protom-org/tk-48/README.md

# tk-48

- 8048を使ったトレーニングボード。シリアル通信でHEXファイルをボード上のRAM又はEEPROMにアップロードして実行が可能。
- KiCADで設計PCBWayで白レジスト基板を作成。

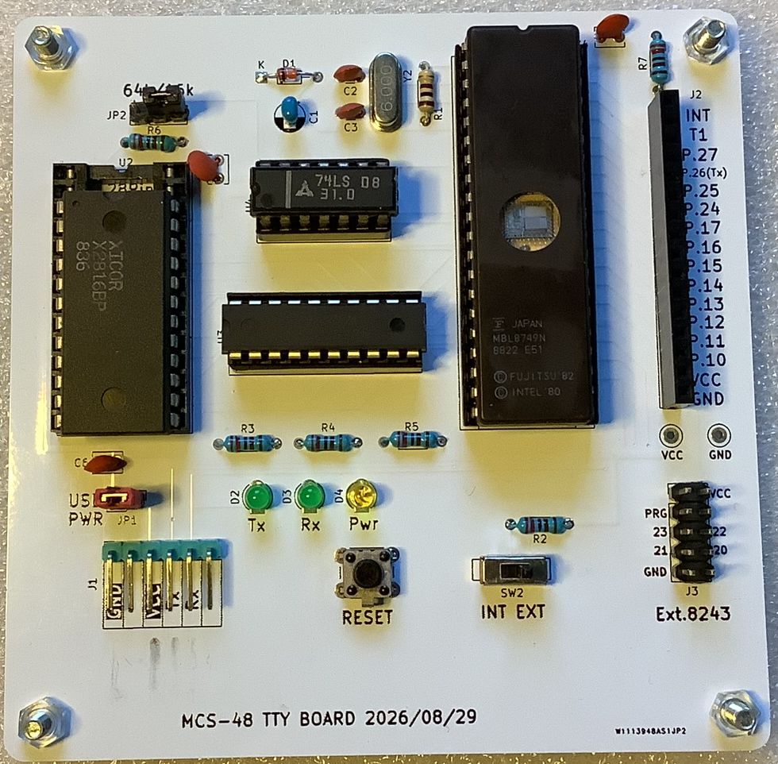
[picture p1: doc/assembly.jpg]
組立完成

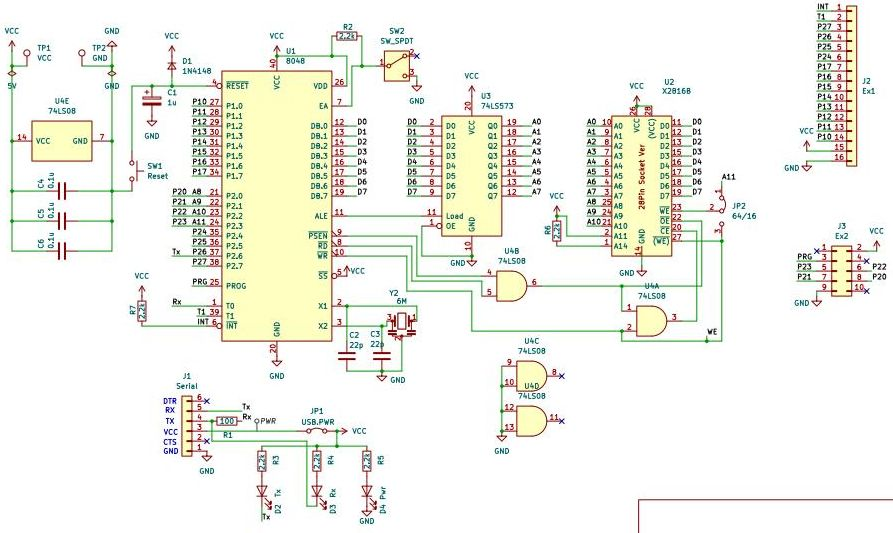
[picture p2: doc/tk48-schematic.jpg]
回路図

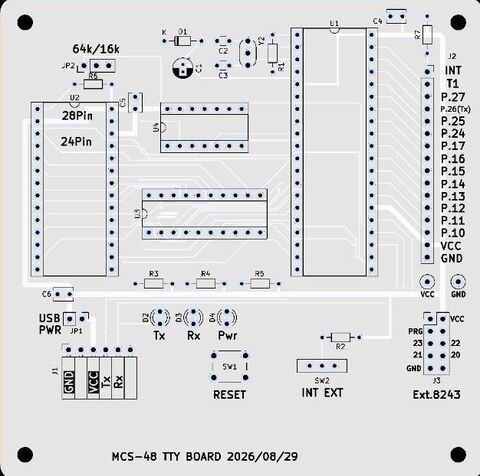
[picture p3: doc/board.jpg]
ボード


## [サポートサイトのWebページ](https://www.protom.org/micon/tk-48)
