protom-org/tk-48/doc/tk48-schematic.pdf

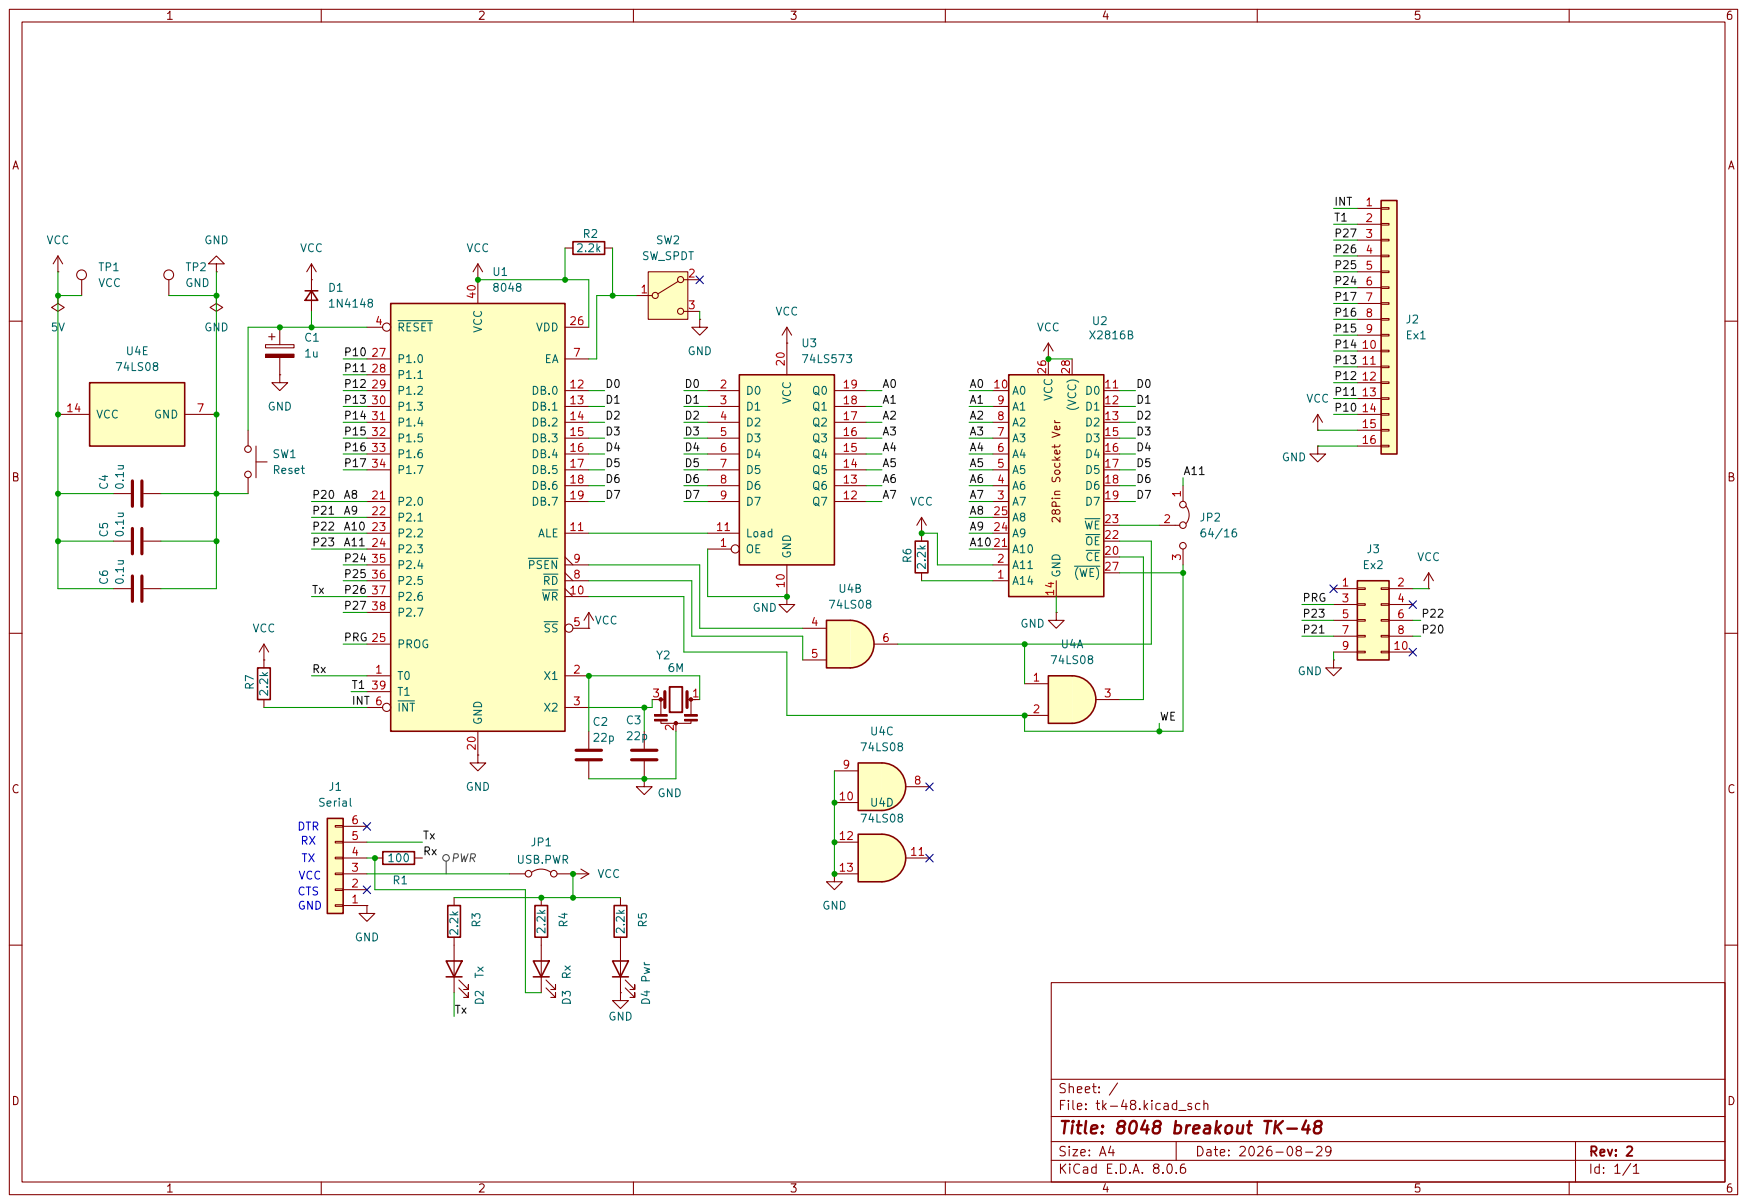
[picture p4: page 1]
