protom-org/tk-48/kicad/tk-48.kicad_pcb

## KiCad design kicad/tk-48.kicad_pcb (2026-11-13)

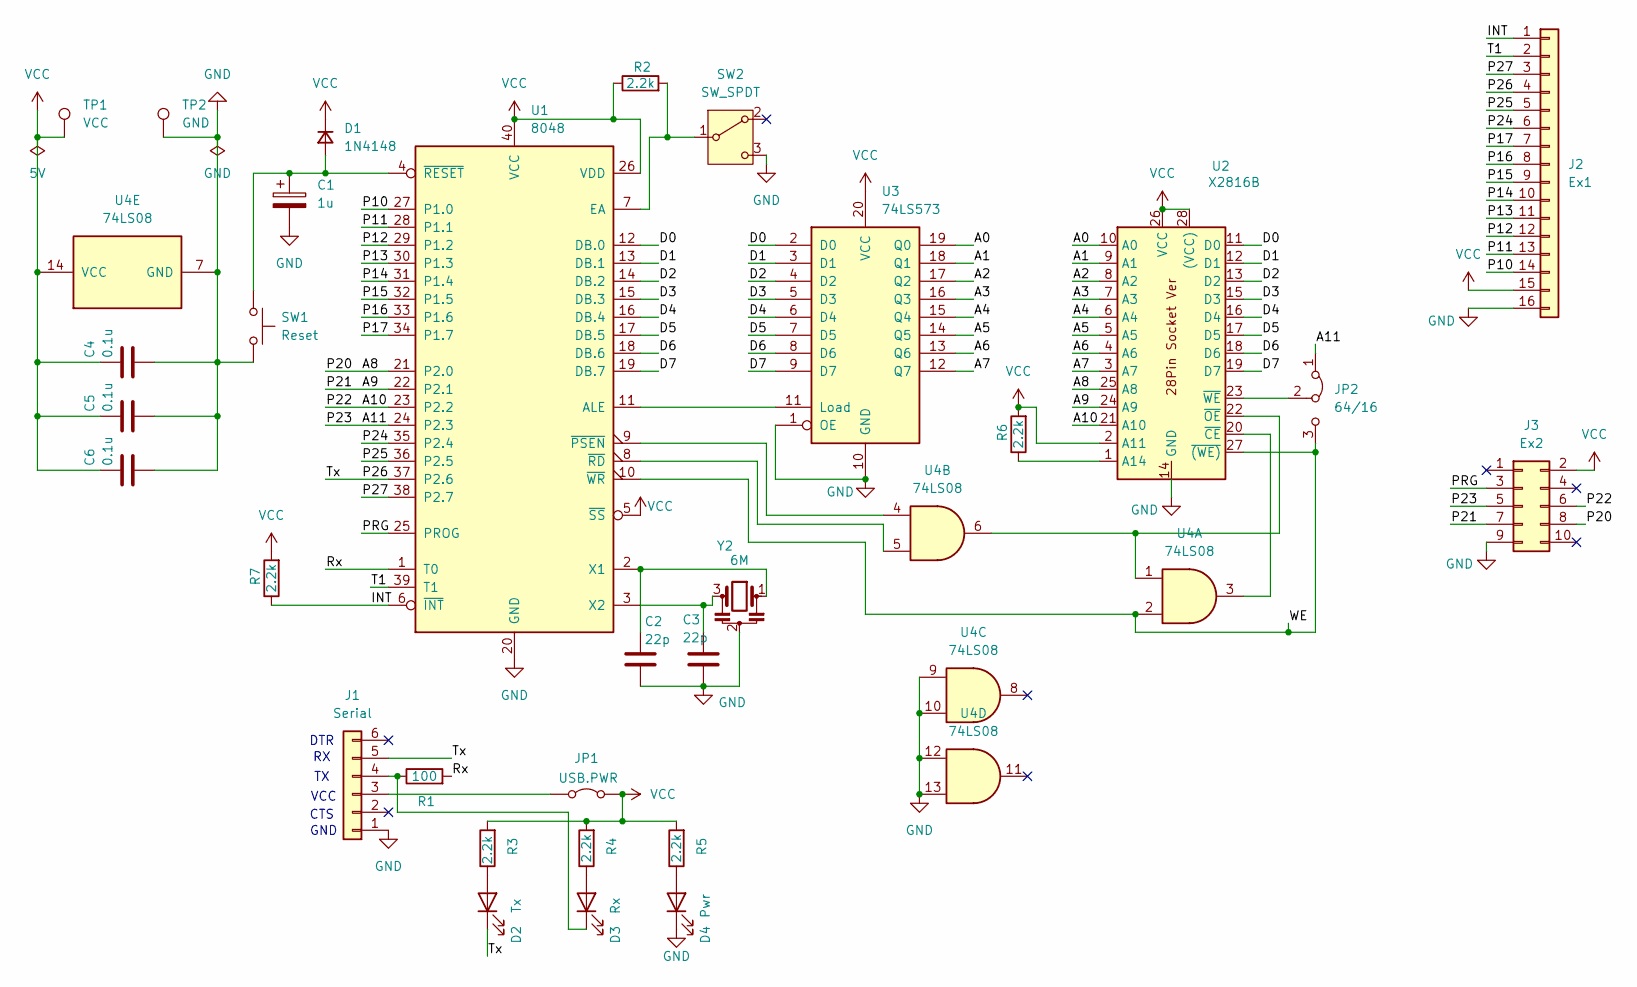
[picture p5: schematic tk-48.kicad_sch, 8048 breakout TK-48]

Parts:
C1: 1u; CP_Radial_D4.0mm_P1.50mm
C2, C3: 22p; C_Disc_D3.0mm_W1.6mm_P2.50mm
C4, C5, C6: 0.1u; C_Disc_D3.8mm_W2.6mm_P2.50mm
D1: 1N4148; D_DO-34_SOD68_P7.62mm_Horizontal
D2: Tx; LED_D3.0mm
D3: Rx; LED_D3.0mm
D4: Pwr; LED_D3.0mm
J1: Serial; PinHeader_1x06_P2.54mm_Horizontal
J2: Ex1; PinSocket_1x16_P2.54mm_Vertical
J3: Ex2; PinHeader_2x05_P2.54mm_Vertical
JP1: USB.PWR; PinHeader_1x02_P2.54mm_Vertical
JP2: 64/16; PinHeader_1x03_P2.54mm_Vertical
R1: 100; R_Axial_DIN0204_L3.6mm_D1.6mm_P7.62mm_Horizontal
R2, R3, R4, R5, R6, R7: 2.2k; R_Axial_DIN0204_L3.6mm_D1.6mm_P7.62mm_Horizontal
SW1: Reset; SW_PUSH_6mm_H8.5mm
SW2: SW_SPDT; SW_Slide-03_Wuerth-WS-SLTV_10x2.5x6.4_P2.54mm
TP1: VCC; TestPoint_Loop_D1.80mm_Drill1.0mm_Beaded
TP2: GND; TestPoint_Loop_D1.80mm_Drill1.0mm_Beaded
U1: 8048; DIP-40_W15.24mm_Socket
U2: X2816B; DIP-28_W15.24mm_Socket
U3: 74LS573; DIP-20_W7.62mm_Socket
U4: 74LS08; DIP-14_W7.62mm_Socket
Y2: 6M; Resonator_Murata_CSTLSxxxX-3Pin_W5.5mm_H3.0mm

Connections:
/A0: U2.10 (A0), U3.19 (Q0)
/A1: U2.9 (A1), U3.18 (Q1)
/A2: U2.8 (A2), U3.17 (Q2)
/A3: U2.7 (A3), U3.16 (Q3)
/A4: U2.6 (A4), U3.15 (Q4)
/A5: U2.5 (A5), U3.14 (Q5)
/A6: U2.4 (A6), U3.13 (Q6)
/A7: U2.3 (A7), U3.12 (Q7)
/A8: J3.8, U1.21 (P2.0), U2.25 (A8)
/A9: J3.7, U1.22 (P2.1), U2.24 (A9)
/A10: J3.6, U1.23 (P2.2), U2.21 (A10)
/A11: J3.5, JP2.1 (A), U1.24 (P2.3)
/D0: U1.12 (DB.0), U2.11 (D0), U3.2 (D0)
/D1: U1.13 (DB.1), U2.12 (D1), U3.3 (D1)
/D2: U1.14 (DB.2), U2.13 (D2), U3.4 (D2)
/D3: U1.15 (DB.3), U2.15 (D3), U3.5 (D3)
/D4: U1.16 (DB.4), U2.16 (D4), U3.6 (D4)
/D5: U1.17 (DB.5), U2.17 (D5), U3.7 (D5)
/D6: U1.18 (DB.6), U2.18 (D6), U3.8 (D6)
/D7: U1.19 (DB.7), U2.19 (D7), U3.9 (D7)
/INT: J2.1, R7.1, U1.6 (~INT)
/P10: J2.14, U1.27 (P1.0)
/P11: J2.13, U1.28 (P1.1)
/P12: J2.12, U1.29 (P1.2)
/P13: J2.11, U1.30 (P1.3)
/P14: J2.10, U1.31 (P1.4)
/P15: J2.9, U1.32 (P1.5)
/P16: J2.8, U1.33 (P1.6)
/P17: J2.7, U1.34 (P1.7)
/P24: J2.6, U1.35 (P2.4)
/P25: J2.5, U1.36 (P2.5)
/P26: D2.1 (K), J1.5, J2.4, U1.37 (P2.6)
/P27: J2.3, U1.38 (P2.7)
/PRG: J3.3, U1.25 (PROG)
/Rx: R1.2, U1.1 (T0)
/T1: J2.2, U1.39 (T1)
/WE: JP2.3 (B), U1.10 (~WR), U2.27 (~(WE)), U4.2
GND: C1.2, C2.2, C3.2, C4.2, C5.2, C6.2, D4.1 (K), J1.1, J2.16, J3.9, SW1.2, SW2.3 (C), TP2.1, U1.20 (GND), U2.14 (GND), U3.1 (OE), U3.10 (GND), U4.7 (GND), U4.9, U4.10, U4.12, U4.13, Y2.2
unnamed: C1.1, D1.2 (A), SW1.1, U1.4 (~RESET)
unnamed: D2.2 (A), R3.1
unnamed: D3.2 (A), R4.1
unnamed: D3.1 (K), J1.4, R1.1
unnamed: D4.2 (A), R5.1
unnamed: J1.3, JP1.1 (A)
unnamed: JP2.2 (C), U2.23 (~WE)
unnamed: R2.2, SW2.1 (B), U1.7 (EA)
unnamed: U1.11 (ALE), U3.11 (Load)
unnamed: C2.1, U1.2 (X1), Y2.1
unnamed: C3.1, U1.3 (X2), Y2.3
unnamed: U1.9 (~PSEN), U4.4
unnamed: U1.8 (~RD), U4.5
unnamed: R6.1, U2.1 (A14)
unnamed: U2.20 (~CE), U4.3
unnamed: U2.22 (~OE), U4.1, U4.6
VCC: C4.1, C5.1, C6.1, D1.1 (K), J2.15, J3.2, JP1.2 (B), R2.1, R3.2, R4.2, R5.2, R6.2, R7.2, TP1.1, U1.5 (~SS), U1.26 (VDD), U1.40 (VCC), U2.2 (A11), U2.26 (VCC), U2.28 ((VCC)), U3.20 (VCC), U4.14 (VCC)

Notes on the sheet:
CTS
VCC
DTR
GND

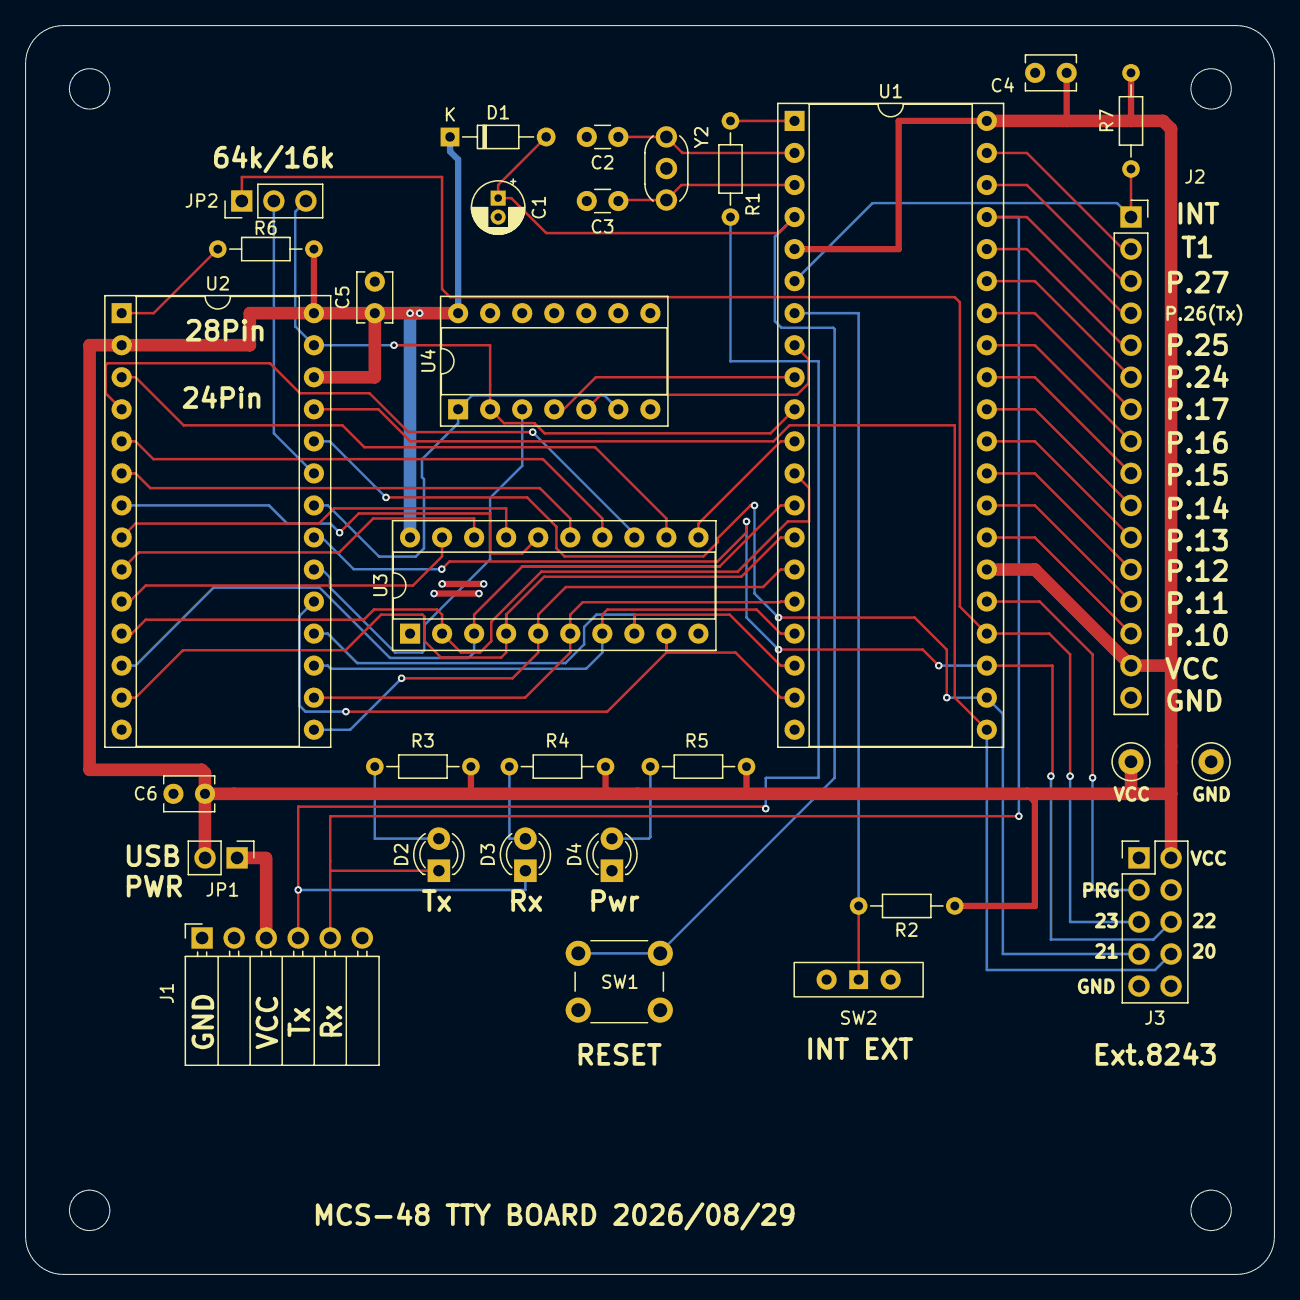
[picture p6: board tk-48.kicad_pcb from above]

Board: 2 copper layers, 99.0 x 99.0 mm, 35 parts (0 on the bottom side), 55 nets.

Other parts of the board:
REF1, REF2, REF3, REF4: MountingHole_3.2mm_M3
